giuliodange/CPS-Demirah/docs/mechanical.md

# Mechanical design

Demirah is a new mechanical system, not a modified DE-Arm. The task needs two rotation axes that carry a mirror and a third actuator that bends the mirror surface, which a serial arm with a gripper does not provide.

| | DE-Arm (starting point) | Demirah |
|---|---|---|
| Actuators | 4 hobby servos, one per joint | 2 geared steppers for the large movements, 1 servo for the surface |
| Positioning | Limited to 180° per joint | 50 steps per degree on the base, 160° of travel, holds position without power |
| Load | Each servo carries the joints after it | Both steppers are in the base: the head carries only the mirror, the servo and the camera |

## Mechanisms

| Motion | Actuator | Mechanism | Why |
|---|---|---|---|
| Rotation | Stepper X, in the base | The body sits on a ball bearing: steel balls between two printed rings | Carries the body without wobbling and with little friction, so a small 5 V stepper is enough |
| Tilt | Stepper Y, in the base | The stepper winds a cord over **two pulleys** inside the body, up to the head. Gravity lowers the head, the cord lifts it | The motor's weight stays low. The cord is always under tension, so there is no backlash |
| Surface | Servo, in the head | The servo drives a **rack** that pushes the centre of the mirror while the ring holds its rim | Pushing the centre bends the sheet into a curve. A servo is fast enough for short gestures |

There are no end stops: the position at power-on counts as zero, and software limits stop the motion.

## Specifications

| | |
|---|---|
| Rotation | 160° (80° each way), 50 steps per degree, up to 16°/s |
| Tilt | 30°, 250 steps per degree, up to 2.8°/s. The high reduction lets a 5 V stepper lift the head, at the cost of speed |
| Surface | Concave to convex over a 1000 µs change of the servo pulse |
| Size | Fits the 605 × 370 × 280 mm project box |

## Materials and fabrication

| Part | Material and process | Why |
|---|---|---|
| Base | 3D-printed PLA | Exact seats for the stepper and the bearing races, and room for the electronics |
| Bearing | Two printed races and 5 mm steel balls | A bearing this wide is not a stock part. Printed into the base, it costs almost nothing |
| Body | 3D-printed, one curved piece | The organic shape and the internal cord channel cannot be laser-cut |
| Head | 3D-printed | Holds the mirror, rack, servo and camera aligned in one part |
| Mirror ring | 3D-printed | Clamps the rim of the mirror and houses the LEDs |
| Mirror | 2 mm flexible mirror sheet | Bends repeatedly without breaking |
| Cord | Lightweight string | Low stretch, so the tilt stays repeatable |

## Assembly

| Exploded view | Assembled |
|---|---|
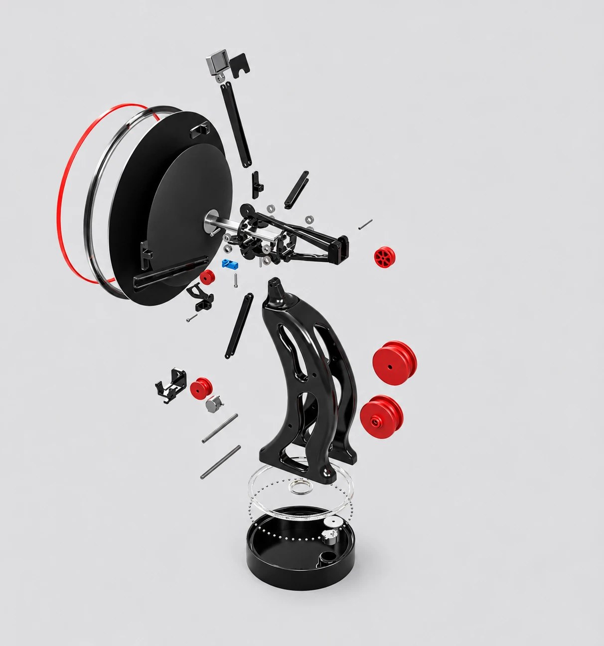
[picture p7: docs/images/exploded-view.jpg]
Exploded view
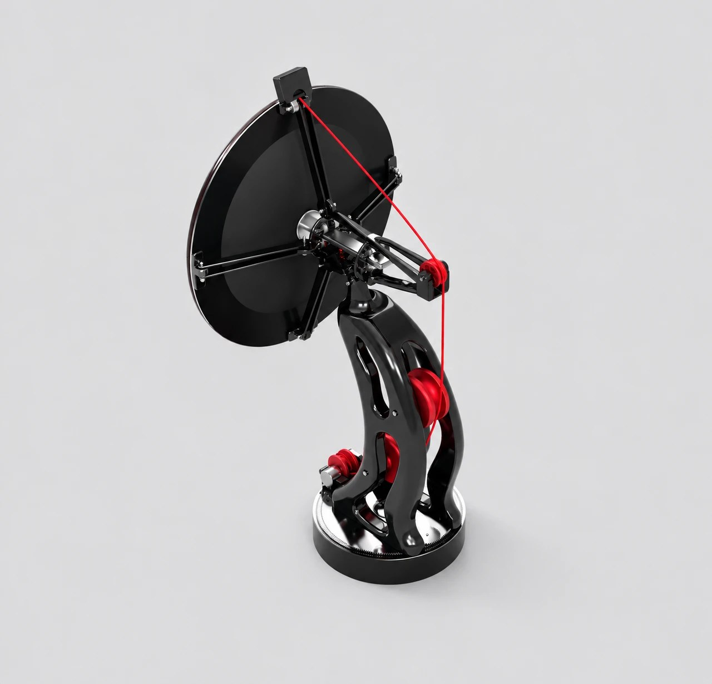
[picture p8: docs/images/assembled-view.jpg]
Assembled view, from the back
|  |  |

The base holds the bearing, stepper X and all the electronics. The body sits on the turntable and carries stepper Y's cord over two pulleys to the head. The head holds the servo and rack, the mirror in its LED ring, and the ESP32-CAM. Wire the parts as in the [schematic](hardware.md#schematic), then set the limits and speeds with [calibration.md](calibration.md).

## Design process

| Prototype | What we learned |
|---|---|
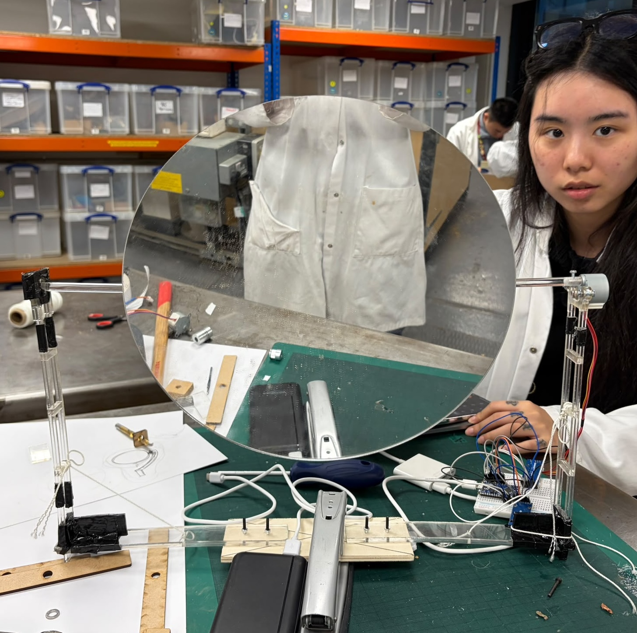
[picture p9: docs/images/prototype-1.jpg]
Prototype 1
|  | First proof of concept. The two arms made the structure too heavy |
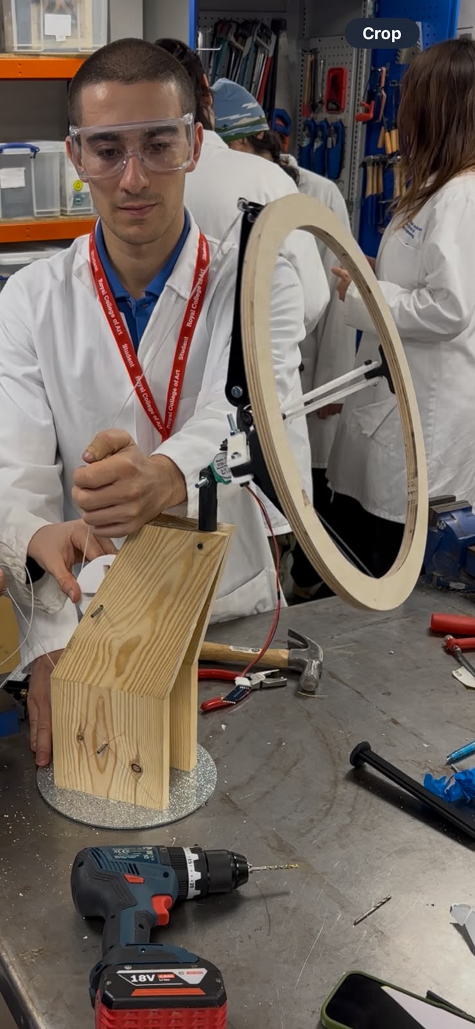
[picture p10: docs/images/prototype-2.jpg]
Prototype 2
|  | Wooden version of the final design: too heavy for the stepper motors |
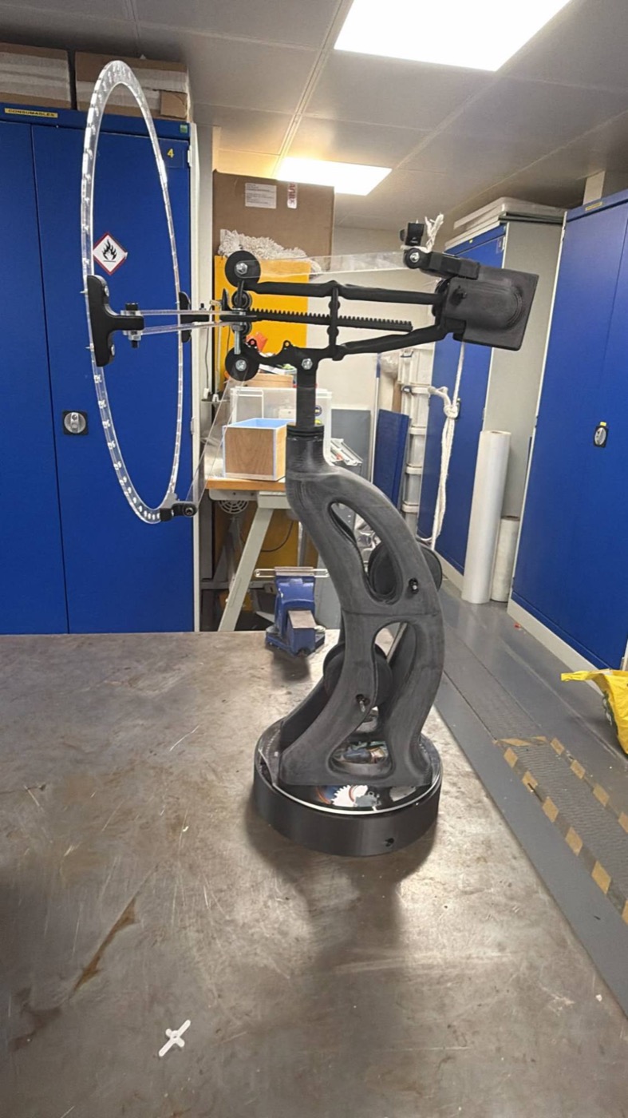
[picture p11: docs/images/prototype-3.jpg]
Prototype 3
|  | The final structure before the mirror and LEDs were fitted. It confirmed that both steppers could move the body from inside the base |
