giuliodange/CPS-Demirah/esp32_cam/CameraWebServer/secrets.example.h

// Copy this file to secrets.h and write your Wi-Fi network in it.
// secrets.h is NOT uploaded to GitHub, so the password stays private.
// Use a 2.4 GHz network, for example a phone hotspot.
#pragma once
const char *ssid = "YOUR_WIFI_NAME";
const char *password = "YOUR_WIFI_PASSWORD";
