giuliodange/CPS-Demirah/(commit log)

2026-11-09 Add interactive mirror: code, Wekinator project and documentation
    Python face tracker (MediaPipe), 5-class Wekinator project with training data,
    Processing behaviour and digital twin, Arduino actuation, ESP32-CAM sketch,
    calibration tool, generated circuit diagram, and docs mapped to the rubric.
    [partitions.csv]
2026-11-10 Drive the convexity servo from timer TCA0 to stop idle twitching
    strip.show() disables interrupts for about 2 ms. The Servo library ends
    each pulse in an interrupt, so pulses were stretched while the idle
    rainbow refreshed 30 times per second. TCA0 now generates the 50 Hz
    pulse on D9 in hardware, in both mirror.ino and calibration.ino.
    [calibration.ino, mirror.ino, mirror.pde]
2026-11-11 Rotate the upside-down mirror camera and soften the shy sweep
    - face_tracker.py turns the ESP32-CAM image 180 degrees before face
    detection (ROTATE_MIRROR_CAMERA); the laptop camera is unchanged.
    - Shy state: rest on one face for SHY_HOLD_S, then glance to the other
    over SHY_GLANCE_S on an ease-in-out curve, with gentle smoothing,
    starting from the face already in view.
    - Calibrated X (+-80 deg, 50 steps/deg) and Y (0-20 deg, 250 steps/deg)
    values, with the same limits in mirror.pde.
2026-11-11 Stop tracking overshoot and let the head reach its full tilt
    - Processing limits each axis to the motor's real speed
    (X_MAX_DEG_PER_S, Y_MAX_DEG_PER_S), so the commanded angle no longer
    runs ahead of the mirror and the closed loop stops overshooting.
    CLOSED_LOOP_GAIN lowered to 0.35.
    - Separate MAX_SPEED/ACCEL for X and Y; Y raised to 1000 steps/s.
    - KEEP_Y_POWERED = true: with the coils off, gravity lowered the head
    and the code lost its position.
    - Y_MAX_DEG = 30 in mirror.pde, matching mirror.ino (it was capped at 20).
    [mirror.ino, mirror.pde]
2026-11-11 Slow stepper Y down so it can lift the head after going sad
    At 1000 steps/s the 28BYJ-48 has too little torque to lift the head
    from the bottom, so after sad it buzzed without rising. MAX_SPEED_Y is
    now 700 and ACCEL_Y 800, with Y_MAX_DEG_PER_S = 2.8 to match.
    calibration.ino gets a "v" command to find the fastest speed that
    still lifts.
    [calibration.ino, mirror.ino, mirror.pde]
2026-11-11 Simplify the code and make it easier to calibrate
    - mirror.ino and mirror.pde: settings grouped as setup / calibrate /
    tune, with fewer constants. The Arduino prints its limits and speeds
    when Processing connects, so the copies in mirror.pde can be checked.
    - mirror.ino: one showLeds() for solid, rainbow and blend; stepper Y
    always holds the head, stepper X rests when idle.
    - mirror.pde: the closed loop aims part of the way to the face angle;
    the shy state sweeps between the two people on a cosine; the mouse
    and laptop modes treat the image centre as straight ahead.
    - face_tracker.py reconnects when the Wi-Fi stream drops.
    - calibration.ino prints the positions when a move ends.
    -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
2026-11-11 Remove the two-people state and add a centre box to tracking
    - The shy state and the second face are gone: only the closest face is
    tracked, and face_tracker.py sends /face only.
    - Tracking rests while the face stays inside a centre box in the image
    (CENTRE_BOX_W x CENTRE_BOX_H). When the face leaves it, the mirror
    re-centres the face to within DEAD_ZONE_DEG, then rests again.
    - The twin shows a small camera view with the box and the face.
2026-11-11 Redesign the five expressions: colour and surface gesture for each
    1 neutral: white, flat. 2 happy: yellow, concave. 3 wink: green, one
    quick push (no head nod). 4 angry: red, the surface shakes. 5 blow:
    blue, slowly pushes out to convex.
    - mirror.pde: the surface follows the emotion instead of keeping the
    zoom; each gesture has its own amount and speed.
    - face_tracker.py: 13 blendshape inputs, with lip scores for "blow"
    instead of the sad ones.
    - docs: new classes, inputs and the steps to record the new Wekinator
    project. The earlier 15-input model is kept for reference.
    [mirror.pde, twin.pde]
2026-11-11 Four expressions: neutral, happy, wink, amazed
    - Amazed replaces angry and blow: rainbow LEDs and a fast pulse of the
    surface. Neutral, happy and wink are unchanged.
    - face_tracker.py sends the original 15 blendshape inputs again, the
    ones the Wekinator project was trained with.
    - Retrained Wekinator project: 5020 examples in 4 classes.
    - docs/machine-learning.md updated with the new classes and data.
    [mirror.pde]
2026-11-11 Reverse the direction of stepper Y
    STEPS_PER_DEG_Y is now negative, so a positive tilt lifts the head.
    [mirror.ino]
2026-11-13 Restructure the documentation around the marking rubric
    - README: concept, interaction and its justification, materials, with
    the physical product and the on-screen simulation in separate
    sections. Placeholders for the four product photos and two GIFs.
    - docs/assembly.md: assembly in 10 steps (pictures are placeholders).
    - docs/mechanical.md: comparison with the DE-Arm, specifications,
    materials and fabrication, design process.
    - docs/hardware.md: every part at 5 V from the module's power bank and
    power board, with references matching a redrawn technical schematic,
    wiring robustness and a power estimate.
    - docs/software.md: why this pipeline, one sketch for the whole
    product, and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
2026-11-13 Replace the text pipeline with a diagram and make the README technical
    - docs/pipeline.svg: a block diagram of the data flow, drawn by
    tools/pipeline_diagram.py in the same style as the schematic.
    - README: the concept, interaction and materials sections now state
    inputs, outputs, values and reasons in technical terms.
2026-11-13 Shorten the documentation and flatten the repository
    - Five documents instead of seven: assembly is now part of
    mechanical.md, and troubleshooting part of calibration.md.
    - All images in one folder, docs/images. The calibration sketch moves
    next to the main one, in arduino/calibration. The empty cad folder
    is removed.
    - Every document is shorter, about 500-700 words. The machine learning
    page keeps data, model, evaluation and training steps, with the
    improvements and limits in 128 words.
    [calibration.ino, mirror.ino]
2026-11-13 Add the product photos, assembly steps and prototype photos
    Replace the placeholders in docs/images with the real pictures, and
    link the demo video, which an <img> tag cannot play.
2026-11-13 Replace the GIFs and assembly steps with one exploded view
    Remove the two GIFs and the ten step pictures. The assembly section in
    mechanical.md is now a single exploded-view image (placeholder) and a
    short description of where each part goes.
2026-11-13 Add the exploded and assembled renders to the assembly section
